botoxparty/poundingsystem-hardware/PoundingSystem.kicad_pcb

## KiCad design PoundingSystem.kicad_pcb (2021-03-08)

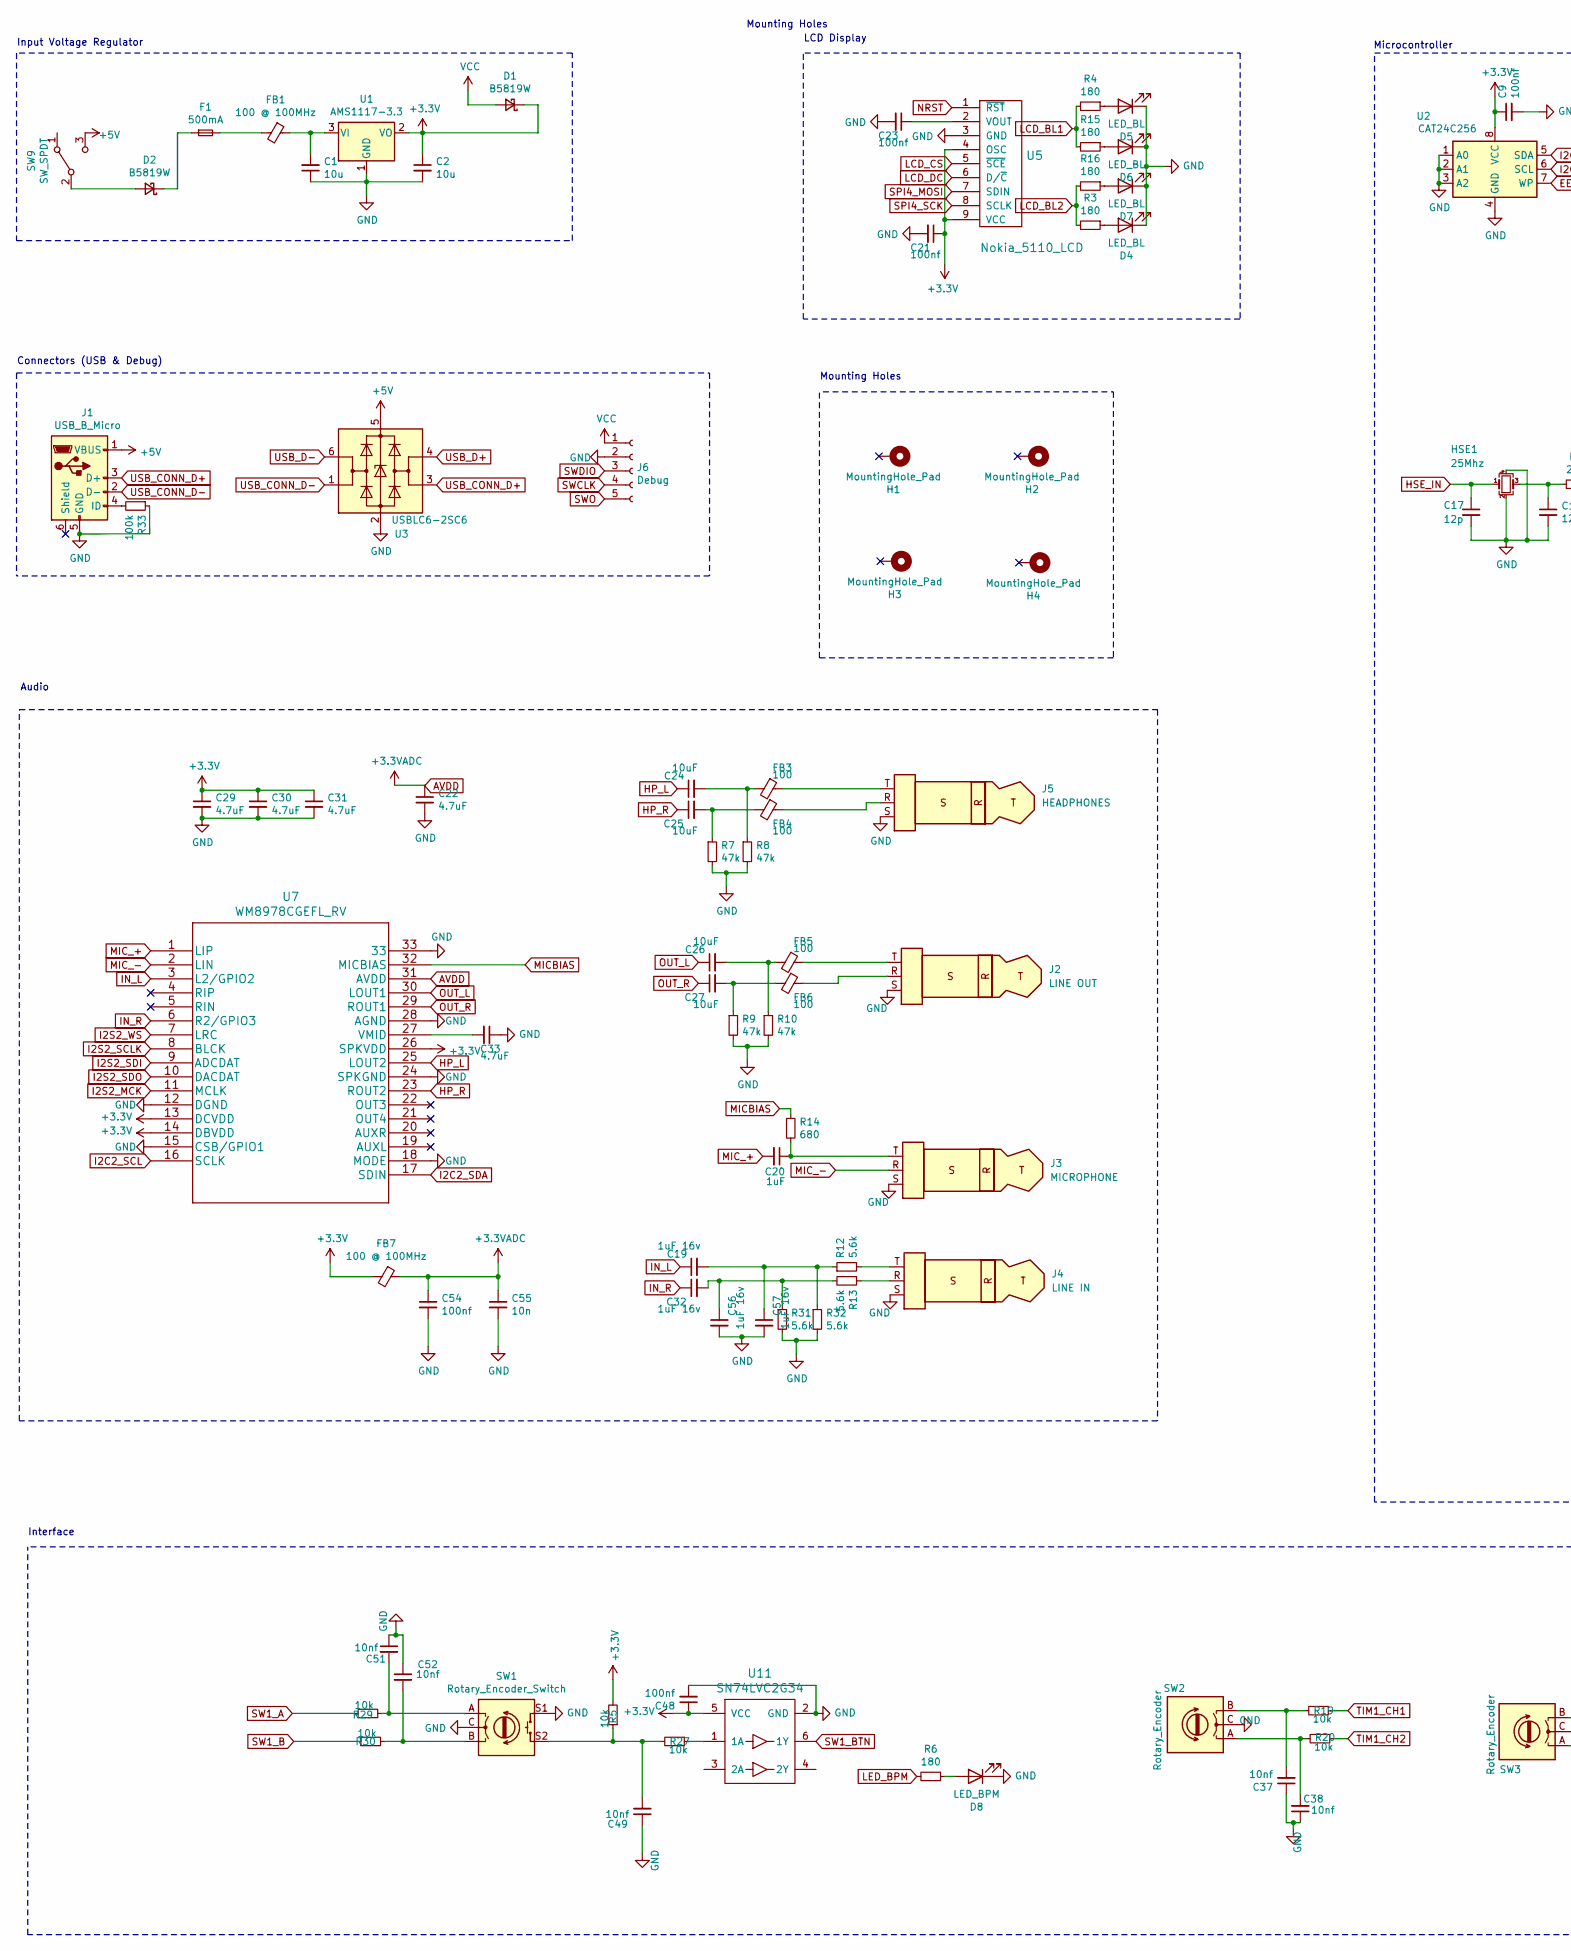
[picture p4: schematic PoundingSystem.sch, PS32, part in row 1, column 1]

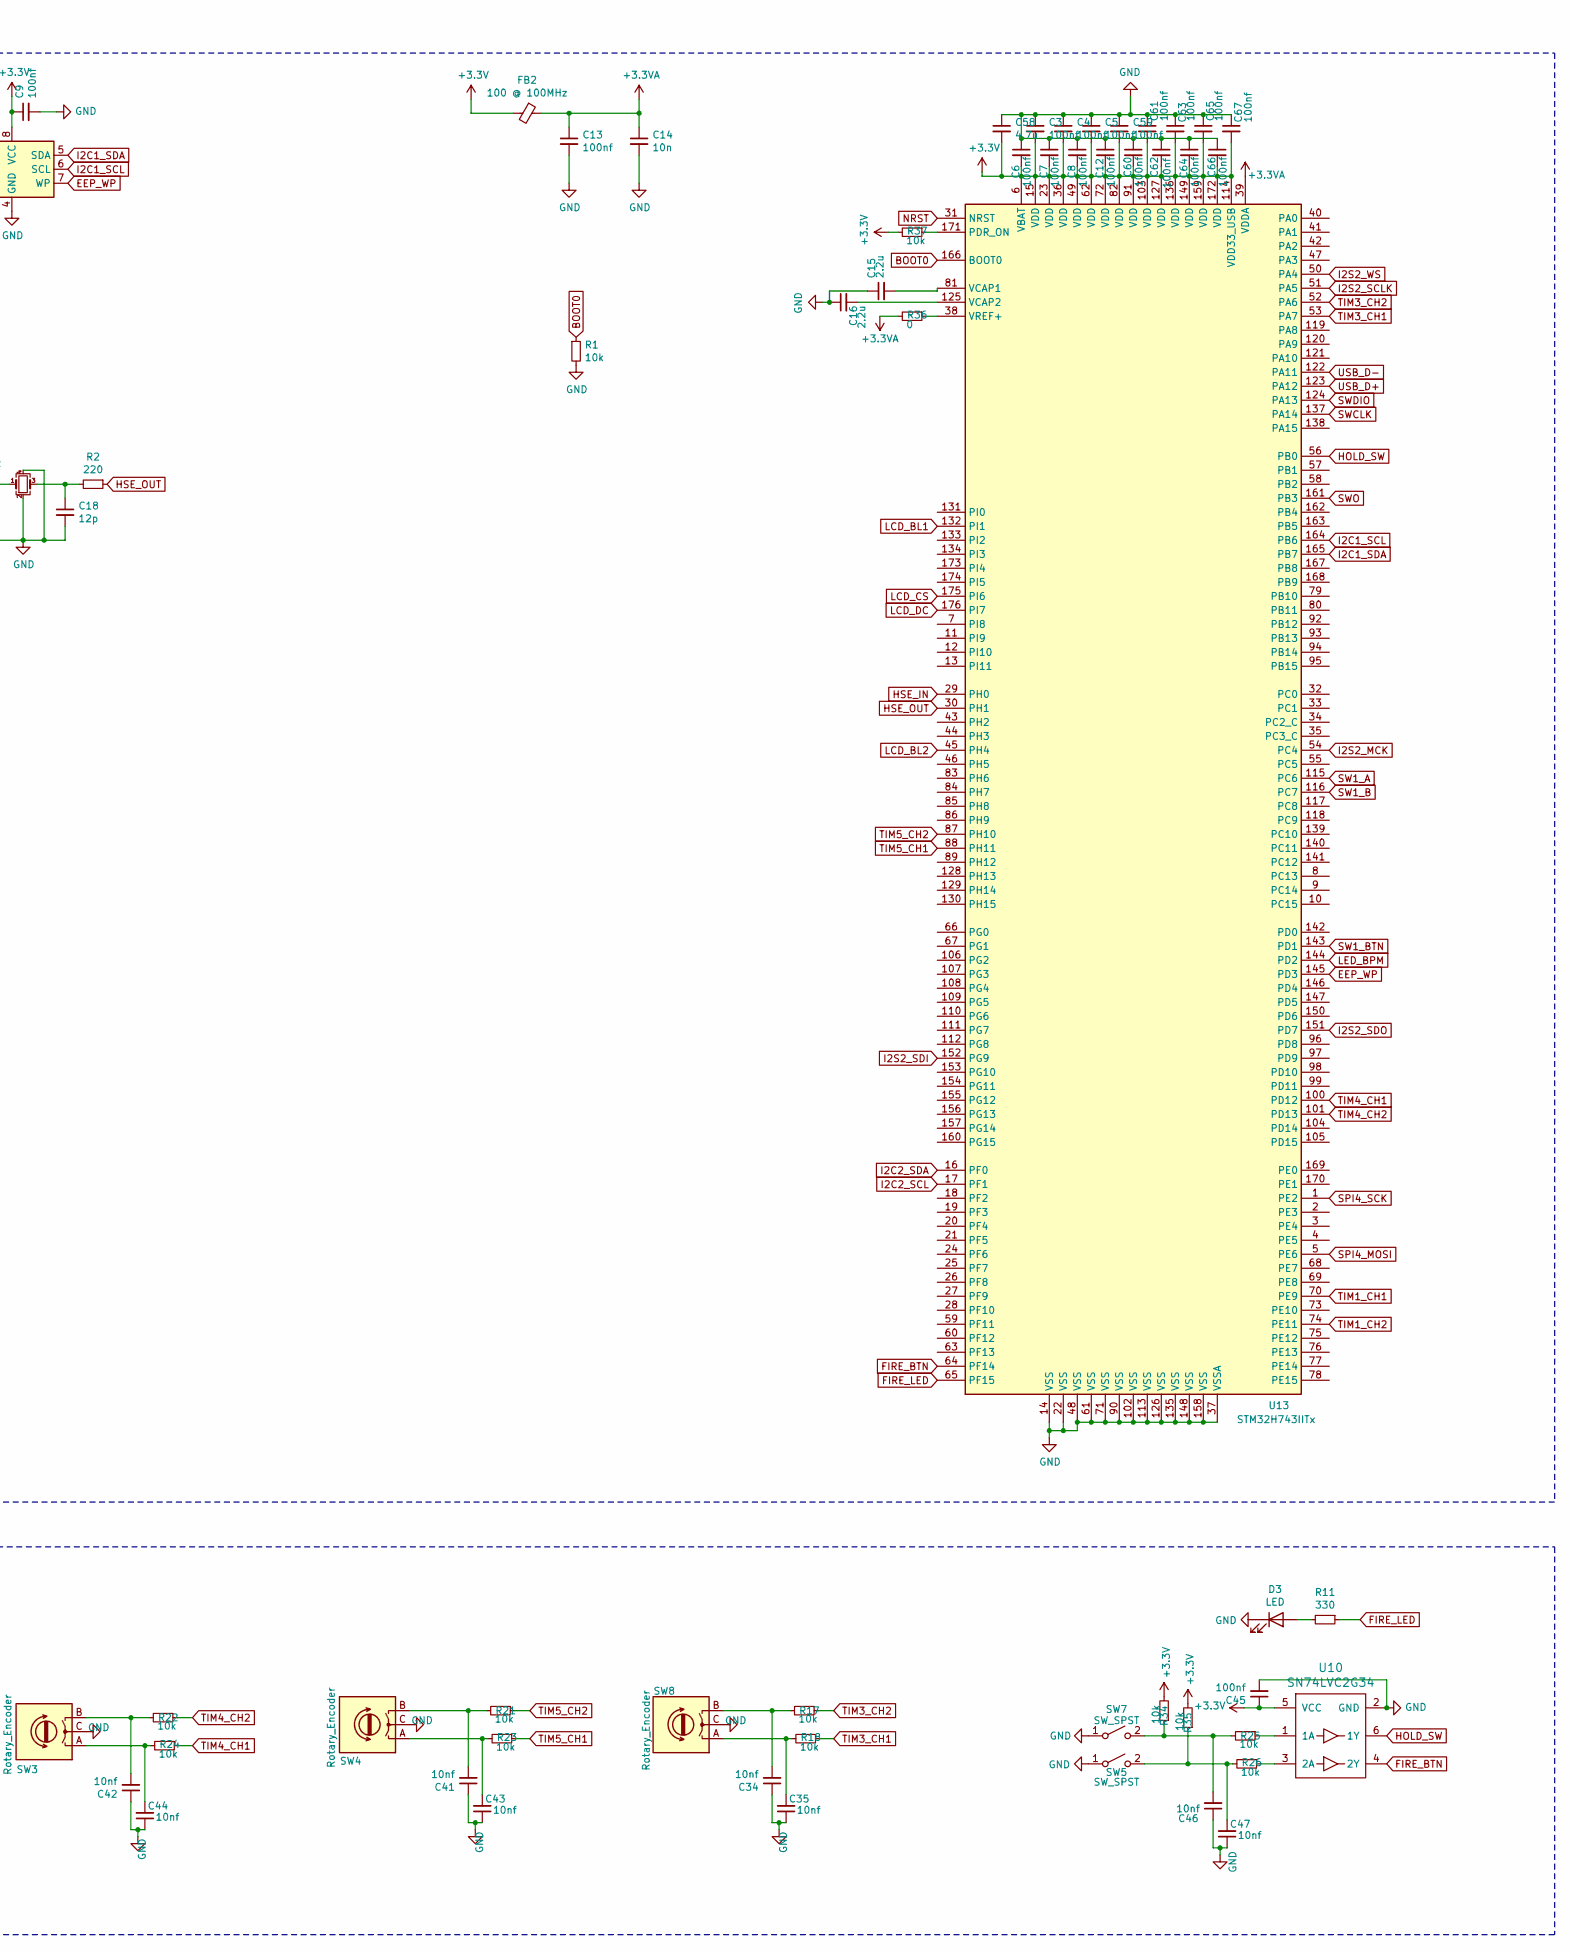
[picture p5: schematic PoundingSystem.sch, PS32, part in row 1, column 2]

Parts:
C1, C2: 10u; C_0805_2012Metric; LCSC Part # C15850
C3, C4, C5, C6, C7, C8, C9, C12, C13, C21, C23, C45, C48, C54, C59, C60, C61, C62, C63, C64, C65, C66, C67: 100nf; C_0402_1005Metric; LCSC Part # C1525
C14, C55: 10n; C_0402_1005Metric; LCSC Part # C15195
C15, C16: 2.2u; C_0603_1608Metric; LCSC Part # C23630
C17, C18: 12p; C_0402_1005Metric; LCSC Part # C1547
C19, C32, C56, C57: 1uF 16v; C_0402_1005Metric; LCSC Part # C52923
C20: 1uF; C_0402_1005Metric; LCSC Part # C52923
C22, C29, C30, C31, C33: 4.7uF; C_0402_1005Metric; LCSC Part # C23733
C24, C25, C26, C27: 10uF; C_0402_1005Metric; LCSC Part # C15525
C34, C35, C37, C38, C41, C42, C43, C44, C46, C47, C49, C51, C52: 10nf; C_0402_1005Metric; LCSC Part # C15195
C58: 4.7u; C_0603_1608Metric; LCSC Part # C19702
D1, D2: B5819W; D_SOD-123; LCSC Part # C8598
D3: LED; LED_0603_1608Metric; LCSC Part # C2286
D4, D5, D6, D7: LED_BL; LED_0805_2012Metric; LCSC Part # C34499
D8: LED_BPM; LED_0805_2012Metric; LCSC Part # C192670
F1: 500mA; Fuse_0603_1608Metric; LCSC Part # C187605
FB1, FB2, FB7: 100 @ 100MHz; L_0805_2012Metric; LCSC Part # C1017
FB3, FB4, FB5, FB6: 100; L_0805_2012Metric; LCSC Part # C1017
H1, H2, H3, H4: MountingHole_Pad; MountingHole_2.2mm_M2_Pad_Via
HSE1: 25Mhz; Crystal_SMD_3225-4Pin_3.2x2.5mm; LCSC Part # C9006
J1: USB_B_Micro; USB_Micro-B_Molex-105017-0001; LCSC Part # C136000
J2: LINE OUT; AudioPJ-320B
J3: MICROPHONE; AudioPJ-320B
J4: LINE IN; AudioPJ-320B
J5: HEADPHONES; AudioPJ-320B
J6: Debug; PinHeader_1x05_P2.54mm_Vertical; LCSC Part # C390682
R1, R5, R17, R18, R19, R20, R21, R22, R23, R24, R25, R26, R27, R29, R30, R34, R35, R37: 10k; R_0402_1005Metric; LCSC Part # C25744
R2: 220; R_0402_1005Metric; LCSC Part # C25091
R3, R4, R6, R15, R16: 180; R_0603_1608Metric; LCSC Part # C22828
R7, R8, R9, R10: 47k; R_0805_2012Metric; LCSC Part # C17713
R11: 330; R_0402_1005Metric; LCSC Part # C25104
R12, R13, R31, R32: 5.6k; R_0805_2012Metric; LCSC Part # C4382
R14: 680; R_0805_2012Metric; LCSC Part # C17798
R33: 100k; R_0402_1005Metric; LCSC Part # C25741
R36: 0; R_0402_1005Metric; LCSC Part # C17168
SW1: Rotary_Encoder_Switch; RotaryEncoder_Alps_EC11E-Switch_Vertical_H20mm
SW2, SW3, SW4: Rotary_Encoder; RotaryEncoder_Alps_EC12E_Vertical_H20mm
SW5: SW_SPST; Cherry-MX-Low-Profile
SW7: SW_SPST; SW_PUSH_6mm_H4.3mm; LCSC Part # C141875
SW8: Rotary_Encoder; RotaryEncoder_Alps_EC12E_Vertical_H20mm_CircularMountingHol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
SW9: SW_SPDT; SS-1290; LCSC Part # C695418
U1: AMS1117-3.3; SOT-223-3_TabPin2; LCSC Part # C6186
U2: CAT24C256; SOIC-8-1EP_3.9x4.9mm_P1.27mm_EP2.29x3mm; LCSC Part # C6482
U3: USBLC6-2SC6; SOT-23-6; LCSC Part # C7519
U5: Nokia_5110_LCD; Nokia_5110-3310_LCD
U7: WM8978CGEFL_RV; WM8960CGEFL&slash_RV; LCSC Part # C323850
U10, U11: SN74LVC2G34; SOT-363_SC-70-6; LCSC Part # C14461
U13: STM32H743IITx; LQFP-176_24x24mm_P0.5mm; LCSC Part # C89597

Connections:
+3.3VA: C13.1, C14.1, FB2.1, R36.2, U13.39 (VDDA)
+3V3: C2.1, C3.2, C4.2, C5.2, C6.2, C7.2, C8.2, C9.1, C12.2, C21.1, C29.1, C30.1, C31.1, C45.1, C48.1, C58.2, C59.2, C60.2, C61.2, C62.2, C63.2, C64.2, C65.2, C66.2, C67.2, D1.1 (K), FB2.2, FB7.2, R5.2, R34.2, R35.2, R37.2, U1.2 (VO), U2.8 (VCC), U5.4 (OSC), U5.9 (VCC), U7.13 (DCVDD), U7.14 (DBVDD), U7.26 (SPKVDD), U10.5 (VCC), U11.5 (VCC), U13.6 (VBAT), U13.15 (VDD), U13.23 (VDD), U13.36 (VDD), U13.49 (VDD), U13.62 (VDD), U13.72 (VDD), U13.82 (VDD), U13.91 (VDD), U13.103 (VDD), U13.114 (VDD33_USB), U13.127 (VDD), U13.136 (VDD), U13.149 (VDD), U13.159 (VDD), U13.172 (VDD)
+5V: J1.1 (VBUS), SW9.3 (C), U3.5 (VBUS)
AVDD: C22.1, C54.1, C55.1, FB7.1, U7.31 (AVDD)
BOOT0: R1.1, U13.166 (BOOT0)
EEP_WP: U2.7 (WP), U13.145 (PD3)
FIRE_BTN: U10.4 (2Y), U13.64 (PF14)
FIRE_LED: R11.1, U13.65 (PF15)
GND: C1.1, C2.2, C3.1, C4.1, C5.1, C6.1, C7.1, C8.1, C9.2, C12.1, C13.2, C14.2, C15.1, C16.1, C17.2, C18.2, C21.2, C22.2, C23.2, C29.2, C30.2, C31.2, C33.1, C34.1, C35.1, C37.1, C38.1, C41.1, C42.1, C43.1, C44.1, C45.2, C46.1, C47.1, C48.2, C49.1, C51.1, C52.1, C54.2, C55.2, C56.2, C57.2, C58.1, C59.1, C60.1, C61.1, C62.1, C63.1, C64.1, C65.1, C66.1, C67.1, D3.1 (K), D4.1 (K), D5.1 (K), D6.1 (K), D7.1 (K), D8.1 (K), HSE1.2, HSE1.4, J1.5 (GND), J2.S, J3.S, J4.S, J5.S, J6.2, R1.2, R7.2, R8.2, R9.2, R10.2, R31.2, R32.2, R33.1, SW1.C, SW1.S1, SW2.C, SW3.C, SW4.C, SW5.1 (A), SW7.1 (A), SW8.C, U1.1 (GND), U2.1 (A0), U2.2 (A1), U2.3 (A2), U2.4 (GND), U3.2 (GND), U5.3 (GND), U7.12 (DGND), U7.15 (CSB/GPIO1), U7.18 (MODE), U7.24 (SPKGND), U7.28 (AGND), U7.33, U10.2 (GND), U11.2 (GND), U13.14 (VSS), U13.22 (VSS), U13.37 (VSSA), U13.48 (VSS), U13.61 (VSS), U13.71 (VSS), U13.90 (VSS), U13.102 (VSS), U13.113 (VSS), U13.126 (VSS), U13.135 (VSS), U13.148 (VSS), U13.158 (VSS)
HOLD_SW: U10.6 (1Y), U13.56 (PB0)
HP_L: C24.1, U7.25 (LOUT2)
HP_R: C25.1, U7.23 (ROUT2)
HSE_IN: C17.1, HSE1.1, U13.29 (PH0)
HSE_OUT: R2.1, U13.30 (PH1)
I2C1_SCL: U2.6 (SCL), U13.164 (PB6)
I2C1_SDA: U2.5 (SDA), U13.165 (PB7)
I2C2_SCL: U7.16 (SCLK), U13.17 (PF1)
I2C2_SDA: U7.17 (SDIN), U13.16 (PF0)
I2S2_MCK: U7.11 (MCLK), U13.54 (PC4)
I2S2_SCLK: U7.8 (BLCK), U13.51 (PA5)
I2S2_SDI: U7.9 (ADCDAT), U13.152 (PG9)
I2S2_SDO: U7.10 (DACDAT), U13.151 (PD7)
I2S2_WS: U7.7 (LRC), U13.50 (PA4)
IN_L: C19.1, U7.3 (L2/GPIO2)
IN_R: C32.1, U7.6 (R2/GPIO3)
LCD_BL1: R4.2, R15.2, U13.132 (PI1)
LCD_BL2: R3.2, R16.2, U13.45 (PH4)
LCD_CS: U5.5 (~SCE), U13.175 (PI6)
LCD_DC: U5.6 (D/~C), U13.176 (PI7)
LED_BPM: R6.2, U13.144 (PD2)
MICBIAS: R14.1, U7.32 (MICBIAS)
MIC_+: C20.2, U7.1 (LIP)
MIC_-: J3.R, U7.2 (LIN)
NRST: U5.1 (~RST), U13.31 (NRST)
unnamed: C1.2, FB1.1, U1.3 (VI)
unnamed: C15.2, U13.81 (VCAP1)
unnamed: C16.2, U13.125 (VCAP2)
unnamed: C18.1, HSE1.3, R2.2
unnamed: C19.2, C57.1, R12.1, R32.1
unnamed: C20.1, J3.T, R14.2
unnamed: C23.1, U5.2 (VOUT)
unnamed: C24.2, FB3.2, R8.1
unnamed: C25.2, FB4.2, R7.1
unnamed: C26.2, FB5.2, R10.1
unnamed: C27.2, FB6.2, R9.1
unnamed: C32.2, C56.1, R13.2, R31.1
unnamed: C33.2, U7.27 (VMID)
unnamed: C34.2, R17.2, SW8.B
unnamed: C35.2, R18.2, SW8.A
unnamed: C37.2, R19.2, SW2.B
unnamed: C38.2, R20.2, SW2.A
unnamed: C41.2, R21.2, SW4.B
unnamed: C42.2, R22.2, SW3.B
unnamed: C43.2, R23.2, SW4.A
unnamed: C44.2, R24.2, SW3.A
unnamed: C46.2, R25.2, R34.1, SW7.2 (B)
unnamed: C47.2, R26.2, R35.1, SW5.2 (B)
unnamed: C49.2, R5.1, R27.2, SW1.S2
unnamed: C51.2, R29.2, SW1.A
unnamed: C52.2, R30.2, SW1.B
unnamed: D2.1 (K), F1.1
unnamed: D2.2 (A), SW9.2 (B)
unnamed: D3.2 (A), R11.2
unnamed: D4.2 (A), R3.1
unnamed: D5.2 (A), R4.1
unnamed: D6.2 (A), R15.1
unnamed: D7.2 (A), R16.1
unnamed: D8.2 (A), R6.1
unnamed: F1.2, FB1.2
unnamed: FB3.1, J5.T
unnamed: FB4.1, J5.R
unnamed: FB5.1, J2.T
unnamed: FB6.1, J2.R
unnamed 74: H2.1; also elsewhere on the board
unnamed: J1.4 (ID), R33.2
unnamed: J4.R, R13.1
unnamed: J4.T, R12.2
unnamed: R25.1, U10.1 (1A)
unnamed: R26.1, U10.3 (2A)
unnamed: R27.1, U11.1 (1A)
unnamed: R36.1, U13.38 (VREF+)
unnamed: R37.1, U13.171 (PDR_ON)
OUT_L: C26.1, U7.30 (LOUT1)
OUT_R: C27.1, U7.29 (ROUT1)
SPI4_MOSI: U5.7 (SDIN), U13.5 (PE6)
SPI4_SCK: U5.8 (SCLK), U13.1 (PE2)
SW1_A: R29.1, U13.115 (PC6)
SW1_B: R30.1, U13.116 (PC7)
SW1_BTN: U11.6 (1Y), U13.143 (PD1)
SWCLK: J6.4, U13.137 (PA14)
SWDIO: J6.3, U13.124 (PA13)
SWO: J6.5, U13.161 (PB3)
TIM1_CH1: R19.1, U13.70 (PE9)
TIM1_CH2: R20.1, U13.74 (PE11)
TIM3_CH1: R18.1, U13.53 (PA7)
TIM3_CH2: R17.1, U13.52 (PA6)
TIM4_CH1: R24.1, U13.100 (PD12)
TIM4_CH2: R22.1, U13.101 (PD13)
TIM5_CH1: R23.1, U13.88 (PH11)
TIM5_CH2: R21.1, U13.87 (PH10)
USB_CONN_D+: J1.3 (D+), U3.3 (I/O2)
USB_CONN_D-: J1.2 (D-), U3.1 (I/O1)
USB_D+: U3.4 (I/O2), U13.123 (PA12)
USB_D-: U3.6 (I/O1), U13.122 (PA11)
VCC: D1.2 (A), J6.1

Notes on the sheet:
Input Voltage Regulator
Microcontroller
Connectors (USB & Debug)
Interface
Audio
Mounting Holes
LCD Display

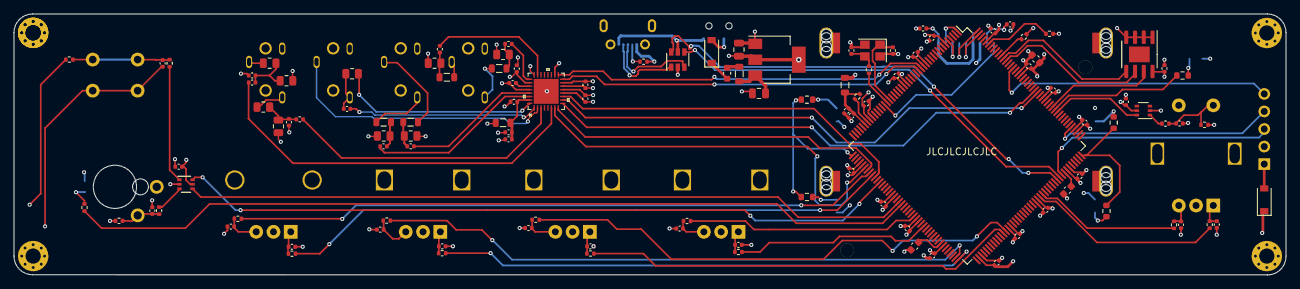
[picture p6: board PoundingSystem.kicad_pcb from above]

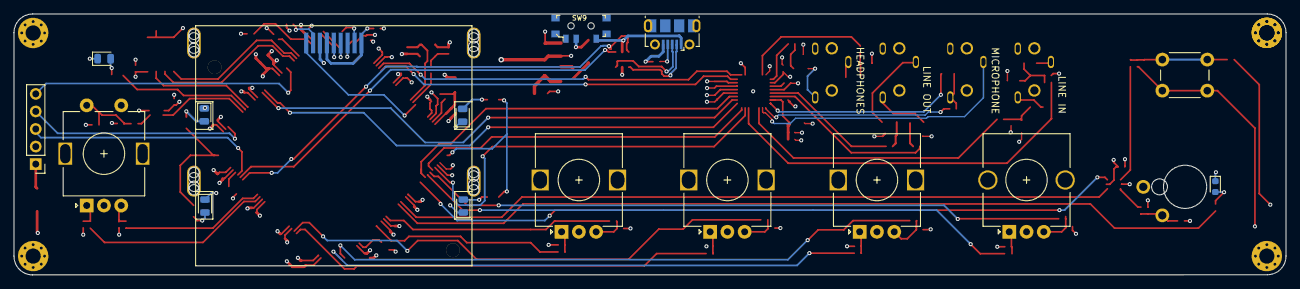
[picture p7: board PoundingSystem.kicad_pcb from below]

Board: 4 copper layers, 184.2 x 37.8 mm, 139 parts (21 on the bottom side), 105 nets.

Other parts of the board:
H2#2: MountingHole_Pad; MountingHole_2.2mm_M2_Pad_Via

Their connections:
unnamed 74: H2#2.1; also elsewhere on the board
