botoxparty/poundingsystem-hardware/(commit log)

2021-01-30 h7 version;
    [PoundingSystem.kicad_pcb, PoundingSystem.sch, PoundingSystem_BottomPlate.kicad_pcb]
2021-02-06 switch MPU to stm32h7
    [PoundingSystem-BOM.csv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]
2021-02-08 production: generate production files
    [PoundingSystem-B_Cu.gbr, PoundingSystem-B_Mask.gbr, PoundingSystem-B_SilkS.gbr, PoundingSystem-Edge_Cuts.gbr, PoundingSystem-F_Cu.gbr, PoundingSystem-F_Mask.gbr, PoundingSystem-F_SilkS.gbr, PoundingSystem-In1_Cu.gbr]
2021-03-08 fix: update schematic labels
    [PoundingSystem.sch]
